PaulZC/Artemis_Global_Tracker/README.md

# Artemis Global Tracker

### We've moved!

This repo has a new home over at [SparkFun](https://github.com/sparkfun/Artemis_Global_Tracker)

_"So long, and thanks for all the fish."_
_(Douglas Adams)_
