PaulZC/Artemis_Global_Tracker/Hardware/Artemis_Iridium_Tracker.brd

## EAGLE design Hardware/Artemis_Iridium_Tracker.brd (2020-02-18)

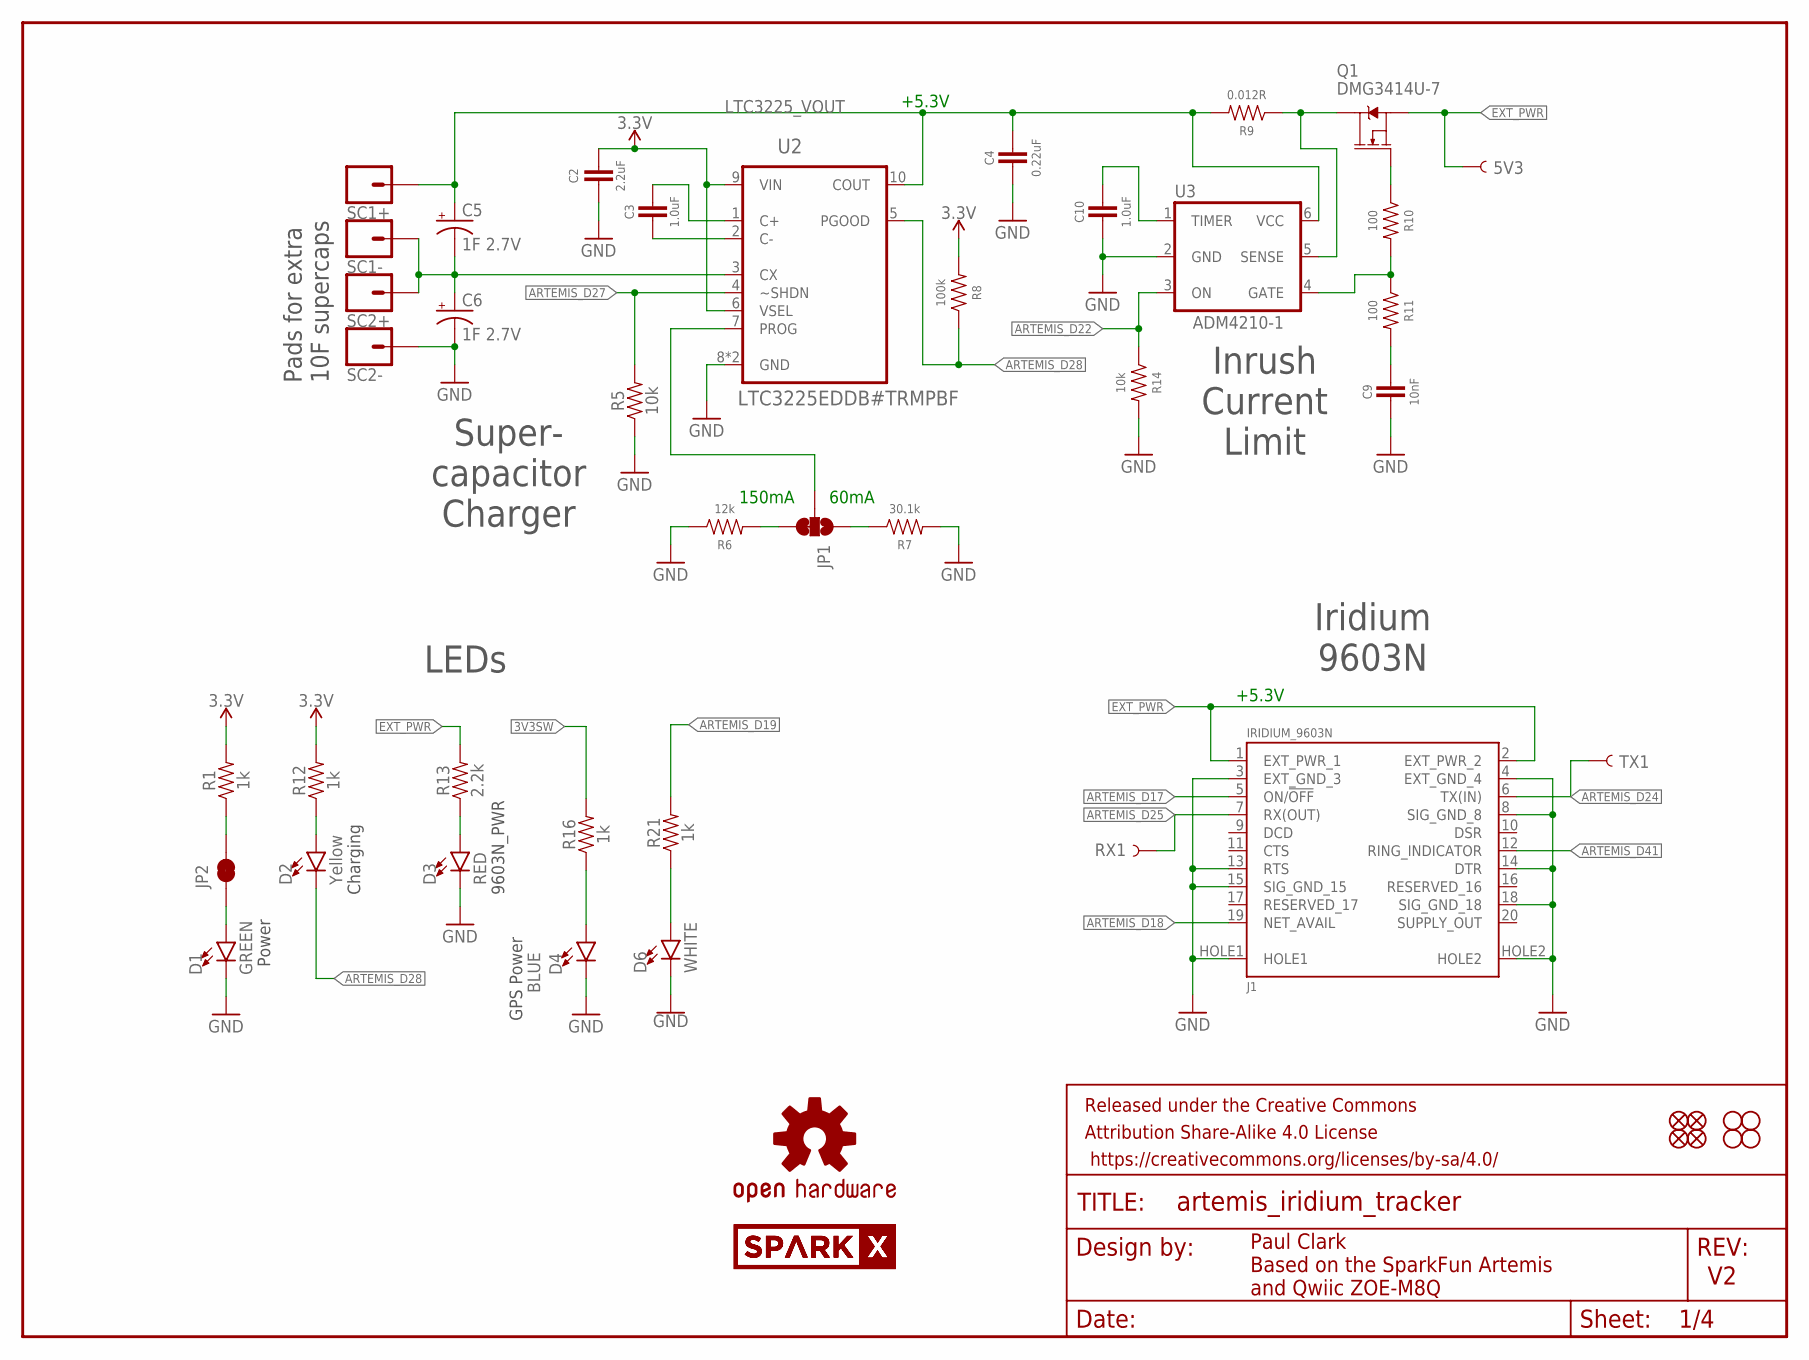
[picture p1: schematic Artemis_Iridium_Tracker.sch, sheet 1]

Parts:
5V3: TEST-POINT3X5; PAD.03X.05
C2: 2.2uF; 0603
C3, C10: 1.0uF; 0603
C4: 0.22uF; 0603
C5, C6: 1F 2.7V; CPOL-RADIAL-1F-2.7V
C9: 10nF; 0603
D1: GREEN; LED-0603
D2: Yellow; LED-0603
D3: RED; LED-0603
D4: BLUE; LED-0603
D6: WHITE; LED-0603
FRAME1: FRAME-LETTER; CREATIVE_COMMONS
J1: IRIDIUM_9603N
JP1: JUMPER-SMT_3_1-NC_TRACE_SILK; SMT-JUMPER_3_1-NC_TRACE_SILK
JP2: JUMPER-SMT_2_NC_TRACE_SILK; SMT-JUMPER_2_NC_TRACE_SILK
JP7, JP8, JP13, JP14: FIDUCIAL1X2; FIDUCIAL-1X2
JP9, JP10, JP11, JP12: STAND-OFF
LOGO4: OSHW-LOGOMINI; OSHW-LOGO-MINI
Q1: DMG3414U-7; SOT23-R
R1, R12, R16, R21: 1k; 0603
R5, R14: 10k; 0603
R6: 12k; 0603
R7: 30.1k; 0603
R8: 100k; 0603
R9: 0.012R; 0603
R10, R11: 100; 0603
R13: 2.2k; 0603
RX1: TEST-POINT3X5; PAD.03X.05
SC1+, SC1-, SC2+, SC2-: CONN_01PTH_NO_SILK_YES_STOP; 1X01_NO_SILK
SPARKX1, SPARKX2: SPARKX-LOGO4; SPARKX-MEDIUM
TX1: TEST-POINT3X5; PAD.03X.05
U2: LTC3225EDDB#TRMPBF; DFN300X200-10L
U3: ADM4210-1; TSOT6

Connections:
3.3V: C2.1, R1.2, R8.2, R12.2, U2.6 (VSEL), U2.9 (VIN); also elsewhere on the board
3V3SW: R16.2; also elsewhere on the board
ARTEMIS_D17: J1.5 (ON/!OFF!); also elsewhere on the board
ARTEMIS_D18: J1.19 (NET_AVAIL); also elsewhere on the board
ARTEMIS_D19: R21.2; also elsewhere on the board
ARTEMIS_D22: R14.1, U3.3 (ON); also elsewhere on the board
ARTEMIS_D24: J1.6 (TX(IN)), TX1.P$1; also elsewhere on the board
ARTEMIS_D25: J1.7 (RX(OUT)), RX1.P$1; also elsewhere on the board
ARTEMIS_D27: R5.2, U2.4 (~SHDN); also elsewhere on the board
ARTEMIS_D28: D2.C, R8.1, U2.5 (PGOOD); also elsewhere on the board
ARTEMIS_D41: J1.12 (RING_INDICATOR); also elsewhere on the board
EXT_PWR: 5V3.P$1, J1.1 (EXT_PWR_1), J1.2 (EXT_PWR_2), Q1.2 (S), R13.2; also elsewhere on the board
GND: C2.2, C4.2, C6.-, C9.2, C10.2, D1.C, D3.C, D4.C, D6.C, J1.3 (EXT_GND_3), J1.4 (EXT_GND_4), J1.8 (SIG_GND_8), J1.13 (RTS), J1.14 (DTR), J1.15 (SIG_GND_15), J1.18 (SIG_GND_18), J1.HOLE1, J1.HOLE2, R5.1, R6.1, R7.2, R14.2, SC2-.1, U2.8 (GND), U2.11 (GND), U3.2 (GND); also elsewhere on the board
LTC3225_VOUT: C4.1, C5.+, R9.2, SC1+.1, U2.10 (COUT), U3.6 (VCC)
unnamed: C5.-, C6.+, SC1-.1, SC2+.1, U2.3 (CX)
unnamed: JP1.3, R6.2
unnamed: JP2.2, R1.1
unnamed: JP1.1, R7.1
unnamed: D2.A, R12.1
unnamed: D3.A, R13.1
unnamed: Q1.3 (D), R9.1, U3.5 (SENSE)
unnamed: C3.2, U2.2 (C-)
unnamed: C3.1, U2.1 (C+)
unnamed: JP1.2, U2.7 (PROG)
unnamed: Q1.1 (G), R10.1
unnamed: R10.2, R11.1, U3.4 (GATE)
unnamed: C9.1, R11.2
unnamed: C10.1, U3.1 (TIMER)
unnamed: D4.A, R16.1
unnamed: D1.A, JP2.1
unnamed: D6.A, R21.1

Notes on the sheet:
Paul Clark Based on the SparkFun Artemis and Qwiic ZOE-M8Q
Power
+5.3V
150mA
60mA
Pads for extra 10F supercaps
Super- capacitor Charger
Charging
9603N_PWR
Iridium 9603N
LEDs
Inrush Current Limit
GPS Power

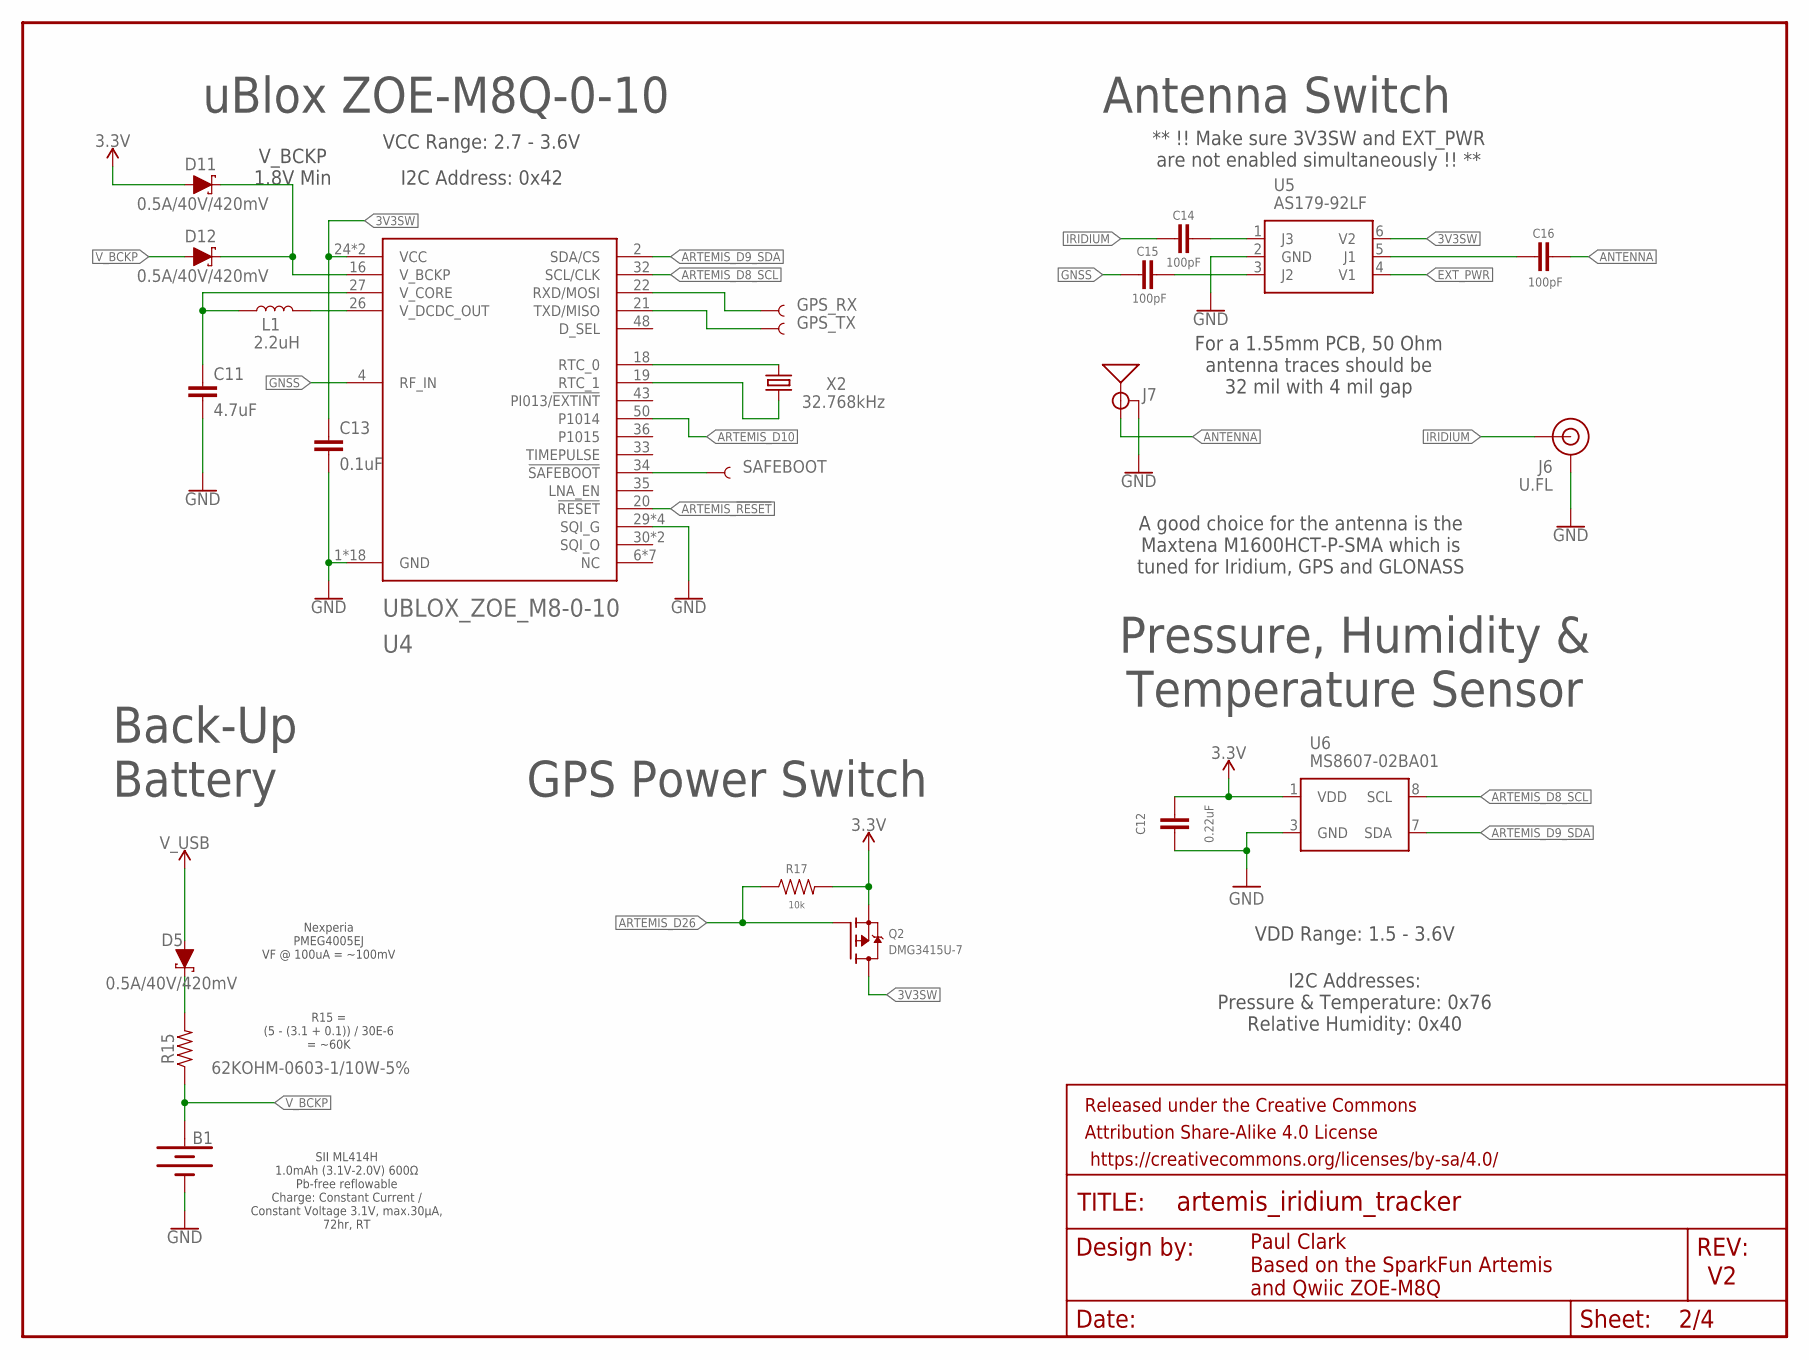
[picture p2: schematic Artemis_Iridium_Tracker.sch, sheet 2]

Parts:
B1: ML414H_IV01E_BATTERY; ML414H_IV01E
C11: 4.7uF; 0603
C12: 0.22uF; 0603
C13: 0.1uF; 0603
C14, C15, C16: 100pF; 0603
D5, D11, D12: 0.5A/40V/420mV; SOD-323
FRAME2: FRAME-LETTER; CREATIVE_COMMONS
GPS_RX: TEST-POINT3X5; PAD.03X.05
GPS_TX: TEST-POINT3X5; PAD.03X.05
J6: U.FL
J7: ANTENNA-GROUNDEDEDGE_SMA; SMA-EDGE
L1: 2.2uH; 0806
Q2: DMG3415U-7; SOT23-R
R15: 62KOHM-0603-1/10W-5%; 0603
R17: 10k; 0603
SAFEBOOT: TEST-POINT3X5; PAD.03X.05
U4: UBLOX_ZOE_M8-0-10
U5: AS179-92LF; SOT65P220X100-6N
U6: MS8607-02BA01
X2: 32.768kHz; CRYSTAL-SMD-3.2X1.5MM

Connections:
3.3V: C12.1, D11.A, Q2.2 (S), R17.2, U6.1 (VDD); also elsewhere on the board
3V3SW: C13.1, Q2.3 (D), U4.24 (VCC), U4.25 (VCC), U5.6 (V2); also elsewhere on the board
ANTENNA: C16.1, J7.SIG (SIGNAL)
ARTEMIS_!RESET: U4.20 (!RESET); also elsewhere on the board
ARTEMIS_D8_SCL: U4.32 (SCL/CLK), U6.8 (SCL); also elsewhere on the board
ARTEMIS_D9_SDA: U4.2 (SDA/CS), U6.7 (SDA); also elsewhere on the board
ARTEMIS_D10: U4.50 (P1014); also elsewhere on the board
ARTEMIS_D26: Q2.1 (G), R17.1; also elsewhere on the board
EXT_PWR: U5.4 (V1); also elsewhere on the board
GND: B1.-, C11.2, C12.2, C13.2, J6.1 (GND), J6.2 (GND), J7.GND@0 (GND), J7.GND@1 (GND), J7.GND@2 (GND), J7.GND@3 (GND), U4.1 (GND), U4.3 (GND), U4.5 (GND), U4.7 (GND), U4.8 (GND), U4.9 (GND), U4.10 (GND), U4.11 (GND), U4.12 (GND), U4.17 (GND), U4.23 (GND), U4.29 (SQI_G), U4.31 (SQI_G), U4.37 (GND), U4.38 (GND), U4.39 (GND), U4.40 (GND), U4.41 (GND), U4.44 (GND), U4.46 (SQI_G), U4.47 (SQI_G), U4.49 (GND), U5.2 (GND), U6.3 (GND); also elsewhere on the board
GNSS: C15.2, U4.4 (RF_IN)
IRIDIUM: C14.2, J6.FEED (SIGNAL)
unnamed: L1.2, U4.26 (V_DCDC_OUT)
unnamed: C11.1, L1.1, U4.27 (V_CORE)
unnamed: U4.18 (RTC_0), X2.P$2 (2)
unnamed: U4.19 (RTC_1), X2.P$1 (1)
unnamed: D5.C, R15.2
unnamed: D11.C, D12.C, U4.16 (V_BCKP)
unnamed: SAFEBOOT.P$1, U4.34 (!SAFEBOOT)
unnamed: GPS_RX.P$1, U4.22 (RXD/MOSI)
unnamed: GPS_TX.P$1, U4.21 (TXD/MISO)
unnamed: C14.1, U5.1 (J3)
unnamed: C15.1, U5.3 (J2)
unnamed: C16.2, U5.5 (J1)
V_BCKP: B1.+, D12.A, R15.1
V_USB: D5.A; also elsewhere on the board

Notes on the sheet:
Paul Clark Based on the SparkFun Artemis and Qwiic ZOE-M8Q
uBlox ZOE-M8Q-0-10
Back-Up Battery
Antenna Switch
SII ML414H 1.0mAh (3.1V-2.0V) 600Ω Pb-free reflowable Charge: Constant Current / Constant Voltage 3.1V, max.30μA, 72hr, RT
VCC Range: 2.7 - 3.6V
I2C Address: 0x42
GPS Power Switch
Pressure, Humidity & Temperature Sensor
VDD Range: 1.5 - 3.6V
I2C Addresses: Pressure & Temperature: 0x76 Relative Humidity: 0x40
** !! Make sure 3V3SW and EXT_PWR are not enabled simultaneously !! **
A good choice for the antenna is the Maxtena M1600HCT-P-SMA which is tuned for Iridium, GPS and GLONASS
For a 1.55mm PCB, 50 Ohm antenna traces should be 32 mil with 4 mil gap
Nexperia PMEG4005EJ VF @ 100uA = ~100mV
R15 = (5 - (3.1 + 0.1)) / 30E-6 = ~60K
V_BCKP 1.8V Min

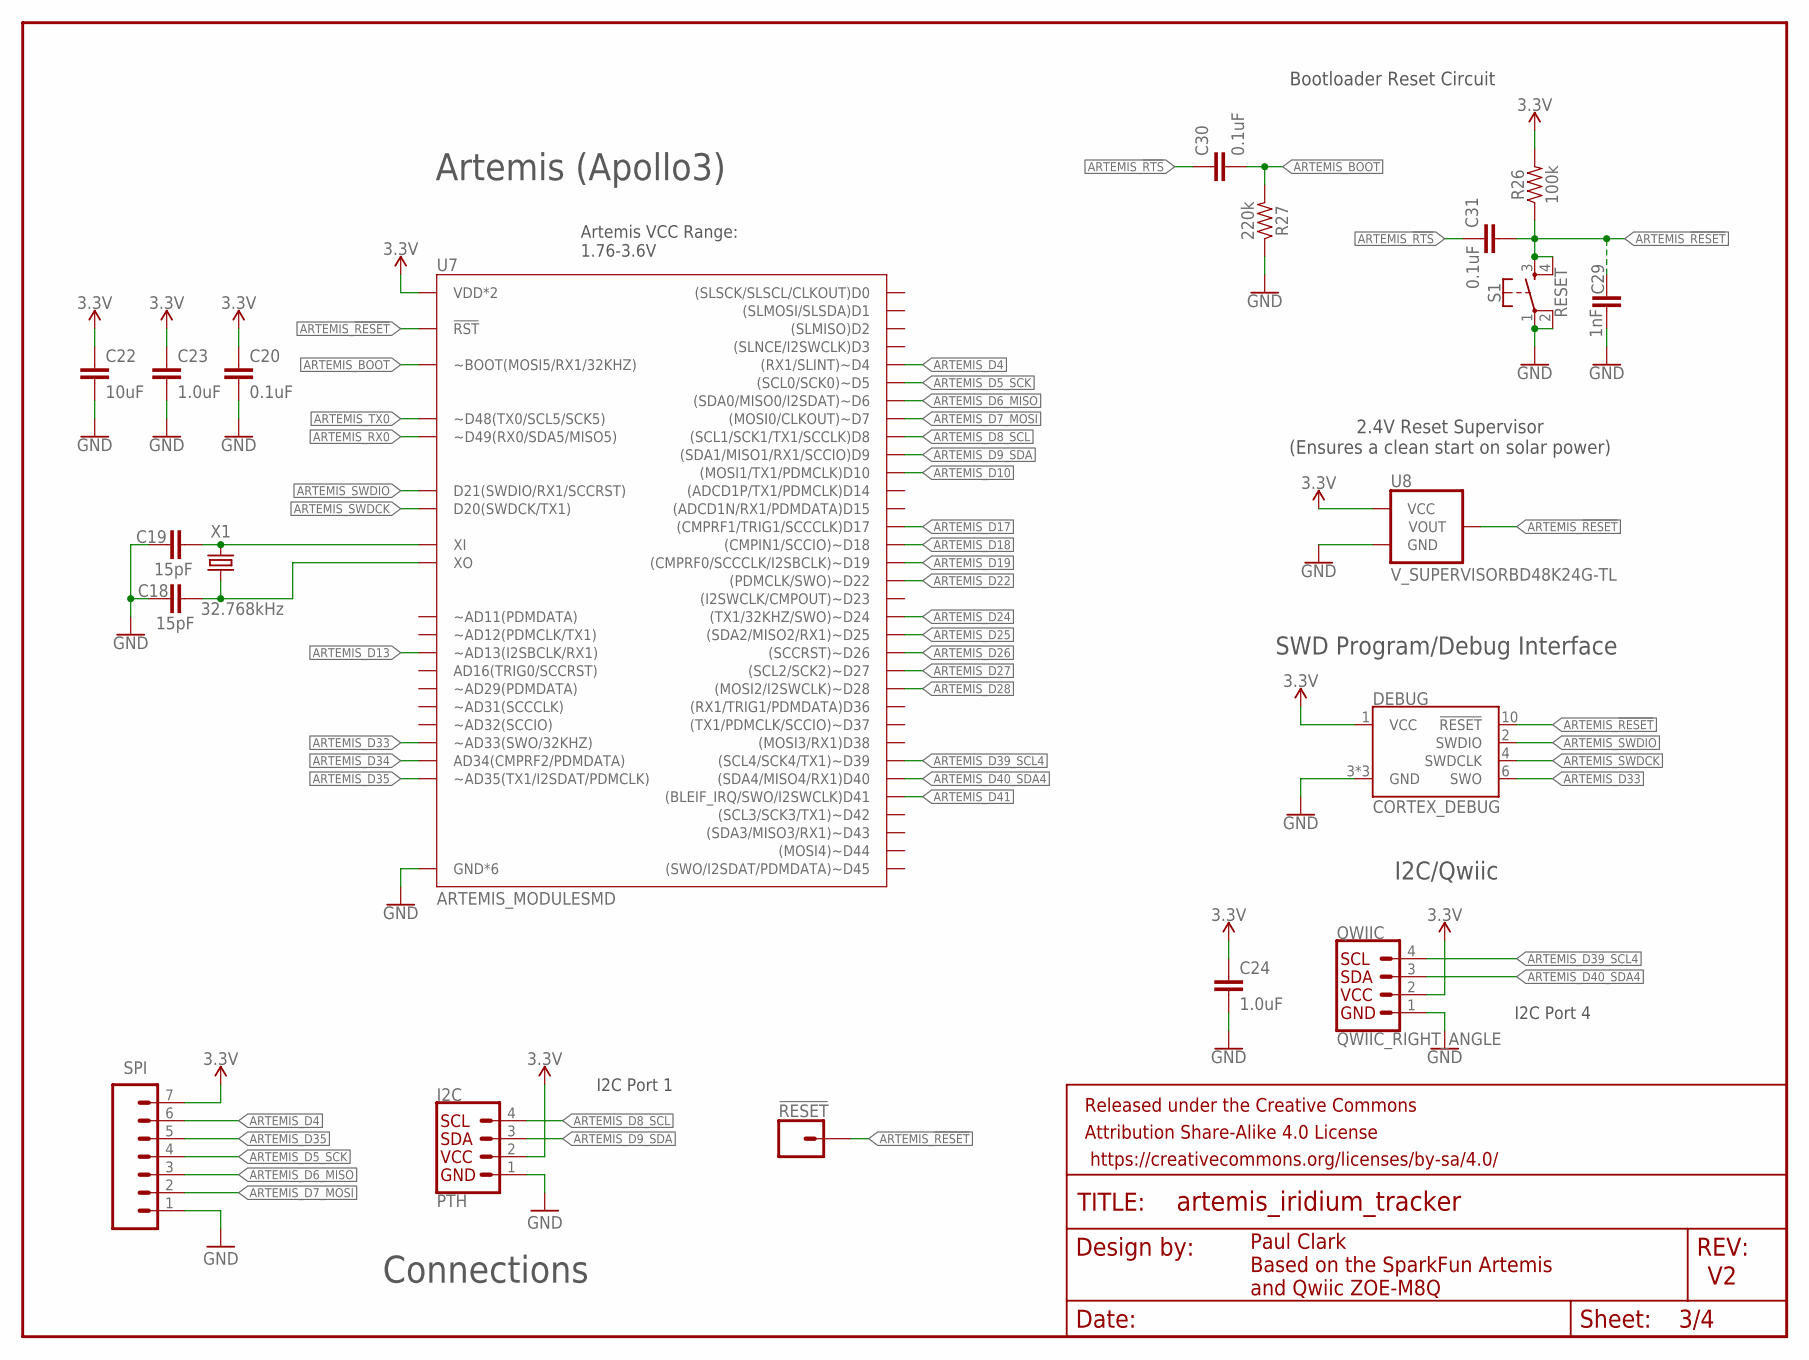
[picture p3: schematic Artemis_Iridium_Tracker.sch, sheet 3]

Parts:
!RESET: CONN_01PTH_NO_SILK_YES_STOP; 1X01_NO_SILK
C18, C19: 15pF; 0603
C20, C30, C31: 0.1uF; 0603
C22: 10uF; 0603
C23, C24: 1.0uF; 0603
C29: 1nF; 0603
DEBUG: CORTEX_DEBUG; 2X5-PTH-1.27MM-NO_SILK
FRAME3: FRAME-LETTER; CREATIVE_COMMONS
I2C: PTH; 1X04_NO_SILK
QWIIC: QWIIC_RIGHT_ANGLE; JST04_1MM_RA
R26: 100k; 0603
R27: 220k; 0603
S1: RESET; TACTILE_SWITCH_SMD_5.2MM
SPI: CONN_07NO_SILK; 1X07_NO_SILK
U7: ARTEMIS_MODULESMD; ARTEMIS_FP
U8: V_SUPERVISORBD48K24G-TL; SSOP3
X1: 32.768kHz; CRYSTAL-SMD-3.2X1.5MM

Connections:
3.3V: C20.2, C22.1, C23.1, C24.1, DEBUG.1 (VCC), I2C.2, QWIIC.2, R26.2, SPI.7, U7.VDD@36 (VDD*2), U7.VDD@37 (VDD*2), U8.3 (VCC); also elsewhere on the board
ARTEMIS_!RESET: !RESET.1, C29.1, C31.2, DEBUG.10 (!RESET), R26.1, S1.3, S1.4, U7.~RST (!RST), U8.2 (VOUT); also elsewhere on the board
ARTEMIS_!RTS!: C30.1, C31.1; also elsewhere on the board
ARTEMIS_BOOT: C30.2, R27.2, U7.BOOT (~BOOT(MOSI5/RX1/32KHZ))
ARTEMIS_D4: SPI.6, U7.~D4 ((RX1/SLINT)~D4)
ARTEMIS_D5_SCK: SPI.4, U7.~D5 ((SCL0/SCK0)~D5)
ARTEMIS_D6_MISO: SPI.3, U7.~D6 ((SDA0/MISO0/I2SDAT)~D6)
ARTEMIS_D7_MOSI: SPI.2, U7.D7 ((MOSI0/CLKOUT)~D7)
ARTEMIS_D8_SCL: I2C.4, U7.D8 ((SCL1/SCK1/TX1/SCCLK)D8); also elsewhere on the board
ARTEMIS_D9_SDA: I2C.3, U7.D9 ((SDA1/MISO1/RX1/SCCIO)D9); also elsewhere on the board
ARTEMIS_D10: U7.D10 ((MOSI1/TX1/PDMCLK)D10); also elsewhere on the board
ARTEMIS_D13: U7.~AD13 (~AD13(I2SBCLK/RX1)); also elsewhere on the board
ARTEMIS_D17: U7.D17 ((CMPRF1/TRIG1/SCCCLK)D17); also elsewhere on the board
ARTEMIS_D18: U7.~D18 ((CMPIN1/SCCIO)~D18); also elsewhere on the board
ARTEMIS_D19: U7.~D19 ((CMPRF0/SCCCLK/I2SBCLK)~D19); also elsewhere on the board
ARTEMIS_D22: U7.~D22 ((PDMCLK/SWO)~D22); also elsewhere on the board
ARTEMIS_D24: U7.~D24 ((TX1/32KHZ/SWO)~D24); also elsewhere on the board
ARTEMIS_D25: U7.~D25 ((SDA2/MISO2/RX1)~D25); also elsewhere on the board
ARTEMIS_D26: U7.~D26 ((SCCRST)~D26); also elsewhere on the board
ARTEMIS_D27: U7.~D27 ((SCL2/SCK2)~D27); also elsewhere on the board
ARTEMIS_D28: U7.~D28 ((MOSI2/I2SWCLK)~D28); also elsewhere on the board
ARTEMIS_D33: DEBUG.6 (SWO), U7.~AD33/SWO (~AD33(SWO/32KHZ))
ARTEMIS_D34: U7.AD34 (AD34(CMPRF2/PDMDATA)); also elsewhere on the board
ARTEMIS_D35: SPI.5, U7.~AD35 (~AD35(TX1/I2SDAT/PDMCLK))
ARTEMIS_D39_SCL4: QWIIC.4, U7.~D39 ((SCL4/SCK4/TX1)~D39)
ARTEMIS_D40_SDA4: QWIIC.3, U7.D40 ((SDA4/MISO4/RX1)D40)
ARTEMIS_D41: U7.D41 ((BLEIF_IRQ/SWO/I2SWCLK)D41); also elsewhere on the board
ARTEMIS_RX0: U7.RXI-0 (~D49(RX0/SDA5/MISO5)); also elsewhere on the board
ARTEMIS_SWDCK: DEBUG.4 (SWDCLK), U7.SWDCK (D20(SWDCK/TX1))
ARTEMIS_SWDIO: DEBUG.2 (SWDIO), U7.SWDIO (D21(SWDIO/RX1/SCCRST))
ARTEMIS_TX0: U7.TXO-0 (~D48(TX0/SCL5/SCK5)); also elsewhere on the board
GND: C18.1, C19.1, C20.1, C22.2, C23.2, C24.2, C29.2, DEBUG.3 (GND), DEBUG.5 (GND), DEBUG.9 (GND), I2C.1, QWIIC.1, R27.1, S1.1, S1.2, SPI.1, U7.GND@1 (GND*6), U7.GND@22 (GND*6), U7.GND@38 (GND*6), U7.GND@39 (GND*6), U7.GND@47 (GND*6), U7.GND@59 (GND*6), U8.1 (GND); also elsewhere on the board
XTALI: C19.2, U7.XI, X1.P$1 (1)
XTALO: C18.2, U7.XO, X1.P$2 (2)

Notes on the sheet:
Paul Clark Based on the SparkFun Artemis and Qwiic ZOE-M8Q
Artemis (Apollo3)
Artemis VCC Range: 1.76-3.6V
Bootloader Reset Circuit
SWD Program/Debug Interface
I2C/Qwiic
Connections
I2C Port 1
I2C Port 4
2.4V Reset Supervisor (Ensures a clean start on solar power)

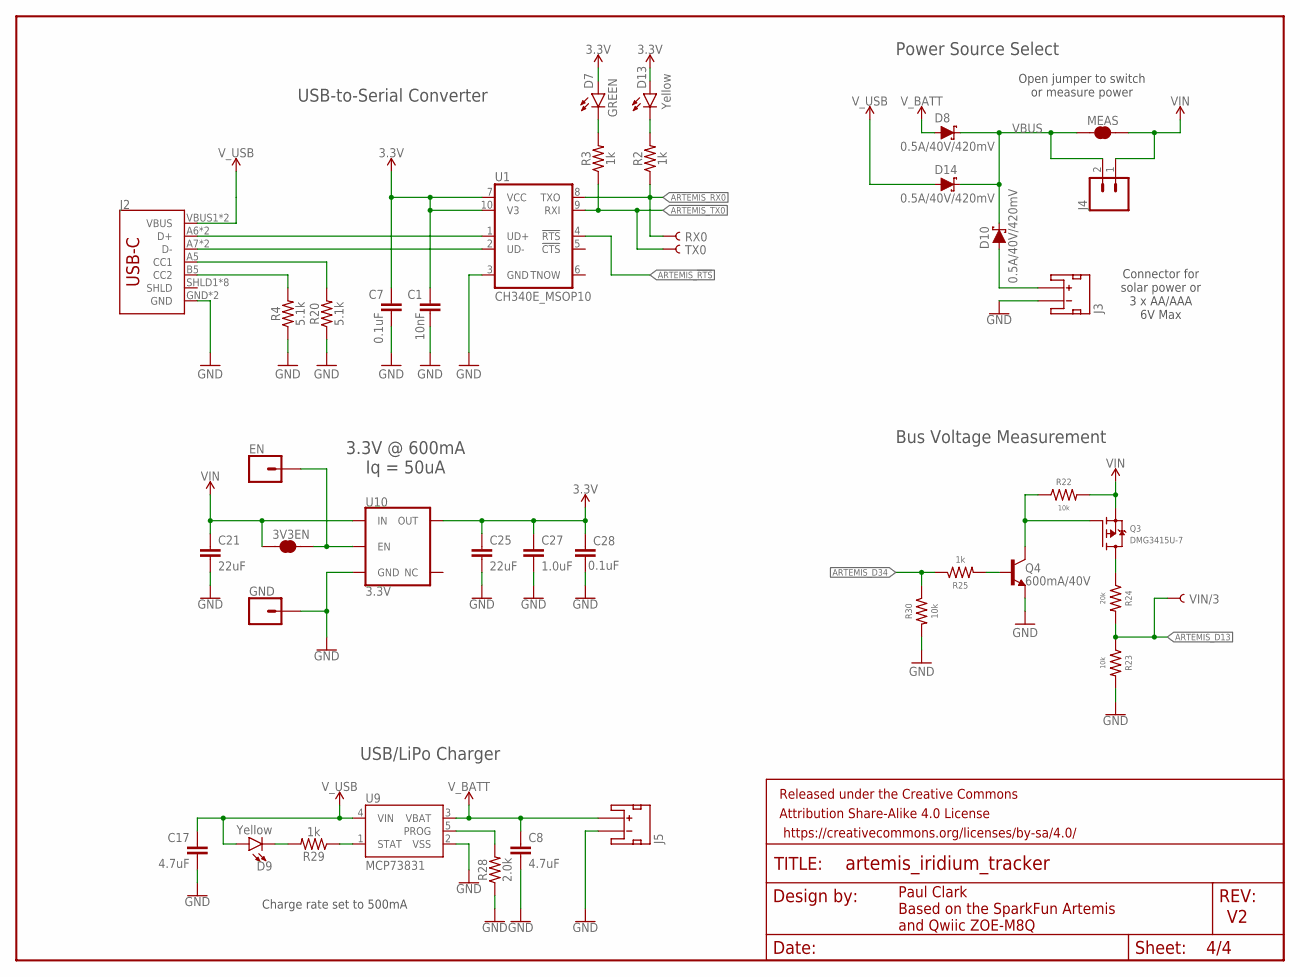
[picture p4: schematic Artemis_Iridium_Tracker.sch, sheet 4]

Parts:
3V3EN: JUMPER-SMT_2_NC_TRACE_SILK; SMT-JUMPER_2_NC_TRACE_SILK
C1: 10nF; 0603
C7, C28: 0.1uF; 0603
C8, C17: 4.7uF; 0603
C21: 22uF; 0805
C25: 22uF; 0603
C27: 1.0uF; 0603
D7: GREEN; LED-0603
D8, D10, D14: 0.5A/40V/420mV; SOD-323
D9, D13: Yellow; LED-0603
EN: CONN_01PTH_NO_SILK_YES_STOP; 1X01_NO_SILK
FRAME4: FRAME-LETTER; CREATIVE_COMMONS
GND: CONN_01PTH_NO_SILK_YES_STOP; 1X01_NO_SILK
J2: USB-C; USB-C-16P
J3, J5: JST_2MM_MALE; JST-2-SMD
J4: CONN_021X02_NO_SILK; 1X02_NO_SILK
MEAS: JUMPER-SMT_2_NC_TRACE_SILK; SMT-JUMPER_2_NC_TRACE_SILK
Q3: DMG3415U-7; SOT23-R
Q4: 600mA/40V; SOT23-3
R2, R3, R25, R29: 1k; 0603
R4, R20: 5.1k; 0603
R22, R23, R30: 10k; 0603
R24: 20k; 0603
R28: 2.0k; 0603
RX0: TEST-POINT3X5; PAD.03X.05
TX0: TEST-POINT3X5; PAD.03X.05
U1: CH340E_MSOP10; MSOP10
U9: MCP73831; SOT23-5
U10: 3.3V; SOT23-5
VIN/3: TEST-POINT3X5; PAD.03X.05

Connections:
3.3V: C1.1, C7.1, C25.1, C27.1, C28.1, D7.A, D13.A, U1.7 (VCC), U1.10 (V3), U10.5 (OUT); also elsewhere on the board
ARTEMIS_!RTS!: U1.4 (!RTS); also elsewhere on the board
ARTEMIS_D13: R23.1, R24.2, VIN/3.P$1; also elsewhere on the board
ARTEMIS_D34: R25.1, R30.1; also elsewhere on the board
ARTEMIS_RX0: R2.1, RX0.P$1, U1.8 (TXO); also elsewhere on the board
ARTEMIS_TX0: R3.1, TX0.P$1, U1.9 (RXI); also elsewhere on the board
CC3: J2.B5 (CC2), R4.2
CC4: J2.A5 (CC1), R20.2
D+2: J2.A6 (D+), J2.B6 (D+), U1.1 (UD+)
D-2: J2.A7 (D-), J2.B7 (D-), U1.2 (UD-)
GND: C1.2, C7.2, C8.2, C17.2, C21.2, C25.2, C27.2, C28.2, GND.1, J2.GND, J2.GND2 (GND), J3.1 (-), J5.1 (-), Q4.2 (E), R4.1, R20.1, R23.2, R28.1, R30.2, U1.3 (GND), U9.2 (VSS), U10.2 (GND); also elsewhere on the board
unnamed: D13.C, R2.2
unnamed: D7.C, R3.2
unnamed: 3V3EN.2, EN.1, U10.3 (EN)
unnamed: Q3.1 (G), Q4.3 (C), R22.1
unnamed: R28.2, U9.5 (PROG)
unnamed: D9.C, R29.2
unnamed: R29.1, U9.1 (STAT)
unnamed: Q3.3 (D), R24.1
unnamed: Q4.1 (B), R25.2
VBUS: D8.C, D10.C, D14.C, J4.2, MEAS.1
VIN: 3V3EN.1, C21.1, J4.1, MEAS.2, Q3.2 (S), R22.2, U10.1 (IN)
V_AAA: D10.A, J3.2 (+)
V_BATT: C8.1, D8.A, J5.2 (+), U9.3 (VBAT)
V_USB: C17.1, D9.A, D14.A, J2.VBUS1 (VBUS), J2.VBUS2 (VBUS), U9.4 (VIN); also elsewhere on the board

Notes on the sheet:
Paul Clark Based on the SparkFun Artemis and Qwiic ZOE-M8Q
3.3V @ 600mA Iq = 50uA
USB/LiPo Charger
Charge rate set to 500mA
Power Source Select
USB-to-Serial Converter
Open jumper to switch or measure power
Connector for solar power or 3 x AA/AAA 6V Max
Bus Voltage Measurement

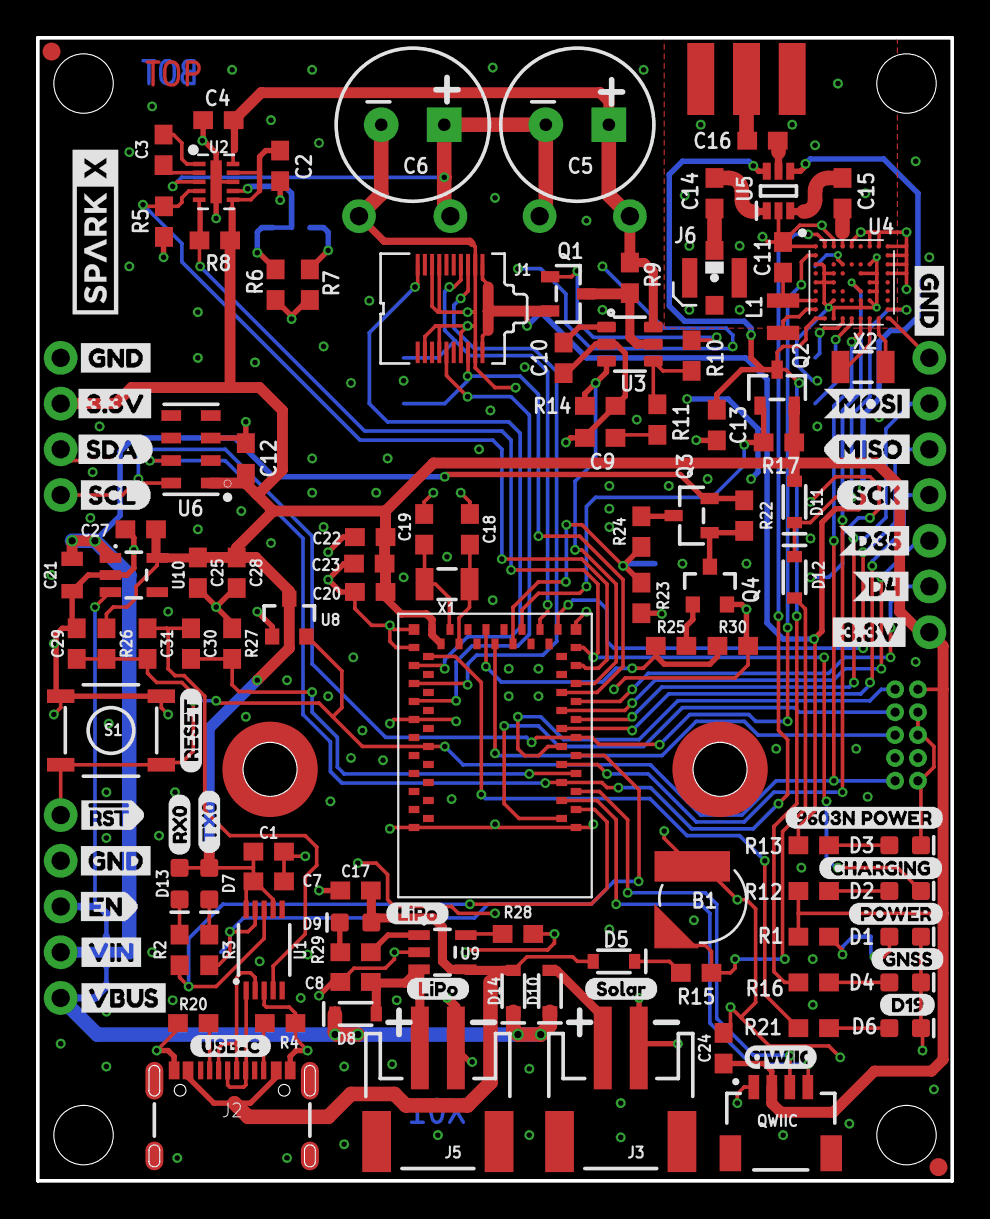
[picture p5: board Artemis_Iridium_Tracker.brd from above]

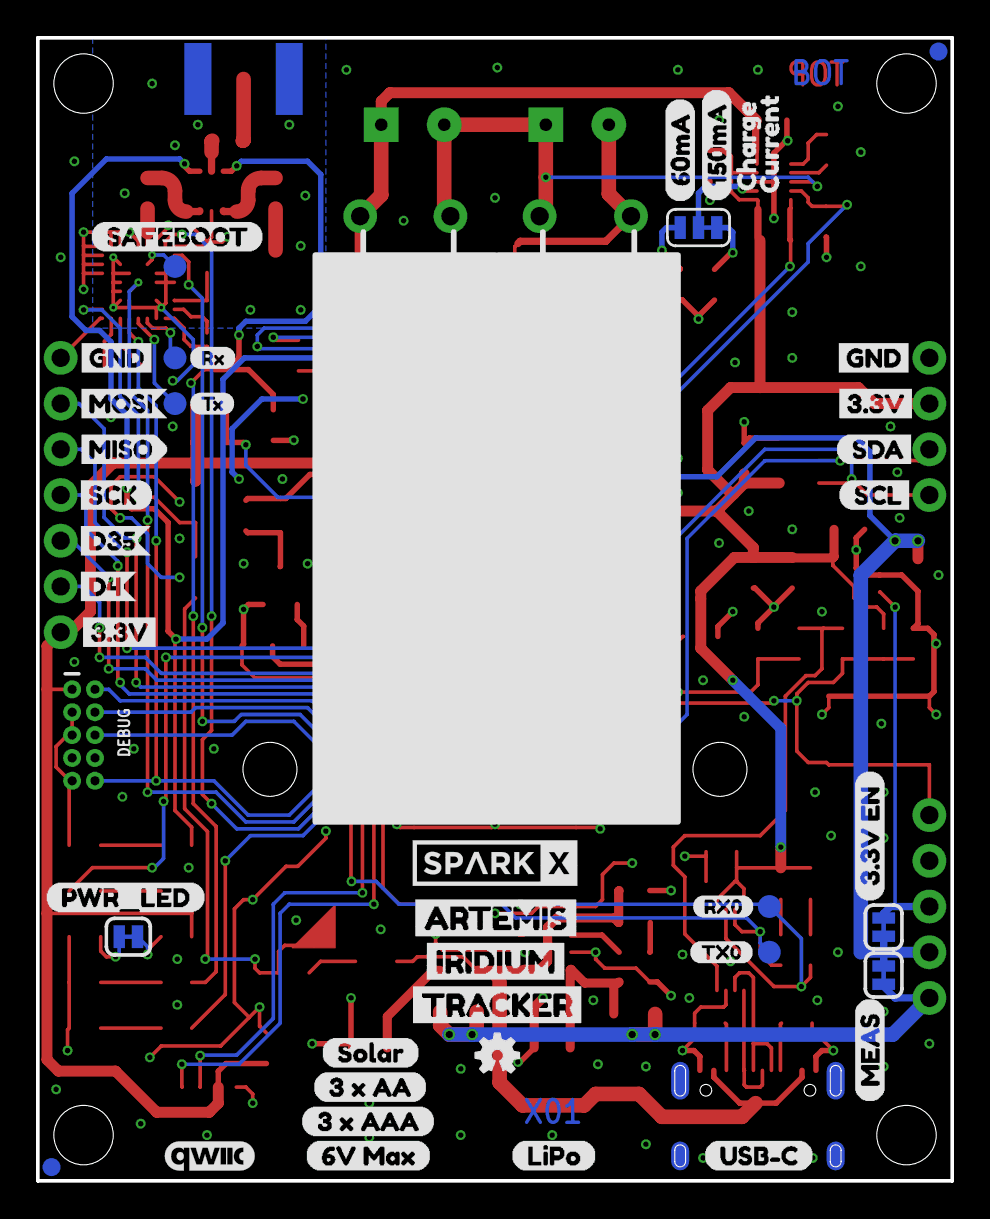
[picture p6: board Artemis_Iridium_Tracker.brd from below]

Board: 2 copper layers, 50.8 x 63.5 mm, 203 parts (55 on the bottom side), 88 nets.

Other parts of the board:
U$1: 60MA0
U$2: POWER0
U$3, U$12, U$17, U$22: GND1
U$4, U$20, U$21, U$24: 3#3V2
U$5: SCL0
U$6: SDA0
U$7: EN0
U$9: CHARGING0
U$10: 9603N_POWER0
U$11: QWIIC_4MM
U$13: 150MA0
U$14: CHARGE0
U$15: CURRENT0
U$16, U$38: TX00
U$18, U$31: SCK0
U$19: GNSS0
U$23, U$34: RX00
U$25: QWIIC_5MM
U$26: SCL9
U$27: SDA8
U$29, U$64: SOLAR0
U$32: 5#3V0
U$33: RX0
U$35: RX10
U$36: SAFEBOOT0
U$37: TX0
U$39: TX10
U$40: ARTEMIS0
U$41: IRIDIUM0
U$42: TRACKER0
U$43: PWR_LED0
U$44: VBUS0
U$45, U$46, U$57: LIPO0
U$47: 3#3V_EN0
U$48: MEAS0
U$49: RESET0
U$50: D190
U$53, U$56: USB#C0
U$58: #RST0
U$59: GND0
U$60: VIN0
U$61: 3_X_AA0
U$62: 3_X_AAA0
U$63: 6V_MAX0
U$65: VIN#30
U$67, U$68: D350
U$69, U$70: MISO0
U$71, U$72: MOSI0
U$73, U$74: D40
