PaulZC/Artemis_Global_Tracker/(commit log)

2019-10-13 Documentation updates plus a near final version of the schematic
    [Artemis_Iridium_Tracker.brd, Artemis_Iridium_Tracker.sch]
2019-11-03 Updated the PCB - still work in progress!
    [Artemis_Iridium_Tracker.brd, Artemis_Iridium_Tracker.sch]
2019-11-07 PCB is routed - grounding needs checking
    [Artemis_Iridium_Tracker.brd, Artemis_Iridium_Tracker.sch]
2019-11-09 Updated the Artemis pins and buck reg EN details
2019-11-09 Final PCB tweaks - ready for prototyping!
    [Artemis_Iridium_Tracker.brd, Artemis_Iridium_Tracker.sch]
2019-11-10 Tweaked the SMA position
    [Artemis_Iridium_Tracker.brd, Artemis_Iridium_Tracker.sch]
2019-12-01 Added the BOM
    [Artemis_Iridium_Tracker_BOM.xlsx]
2020-02-09 Substantial update for V2 (X01) of the PCB
    [Artemis_Iridium_Tracker.brd, Artemis_Iridium_Tracker.sch, Artemis_Iridium_Tracker_BOM.xlsx]
2020-02-15 Updated the PCB - tidied up the libraries
    [Artemis_Iridium_Tracker.brd, Artemis_Iridium_Tracker.sch, Artemis_Iridium_Tracker_BOM.xlsx]
2020-02-18 Updated the PCB and the examples README
    [Artemis_Iridium_Tracker.brd, Artemis_Iridium_Tracker.sch]
2020-02-22 More name changes and updates to the Message Fields definition
    [Artemis_Global_Tracker.brd, Artemis_Global_Tracker.sch, Artemis_Global_Tracker_BOM.xlsx, Artemis_Iridium_Tracker_BOM.xlsx]
2020-03-22 Updated the geofence pin production test
2020-03-22 PROD_ID updates
    [Artemis_Global_Tracker.brd, Artemis_Global_Tracker.sch, Artemis_Global_Tracker_BOM.xlsx]
2020-03-25 Adding panel files.
    [Artemis_Global_Tracker-Panel.GBL, Artemis_Global_Tracker-Panel.GBO, Artemis_Global_Tracker-Panel.GBP, Artemis_Global_Tracker-Panel.GBS, Artemis_Global_Tracker-Panel.GKO, Artemis_Global_Tracker-Panel.GTL, Artemis_Global_Tracker-Panel.GTO, Artemis_Global_Tracker-Panel.GTP]
2020-05-27 Added the link to the SF repo
    [Artemis_Global_Tracker-Panel.GBL, Artemis_Global_Tracker-Panel.GBO, Artemis_Global_Tracker-Panel.GBP, Artemis_Global_Tracker-Panel.GBS, Artemis_Global_Tracker-Panel.GKO, Artemis_Global_Tracker-Panel.GTL, Artemis_Global_Tracker-Panel.GTO, Artemis_Global_Tracker-Panel.GTP]
